HieuTkZ/Graduation-internship-LoRaWAN-Smoke-Monitor/csv_downloaded/smoke_log_1_2026-09-26_20-32-47/comparison_normalized.png

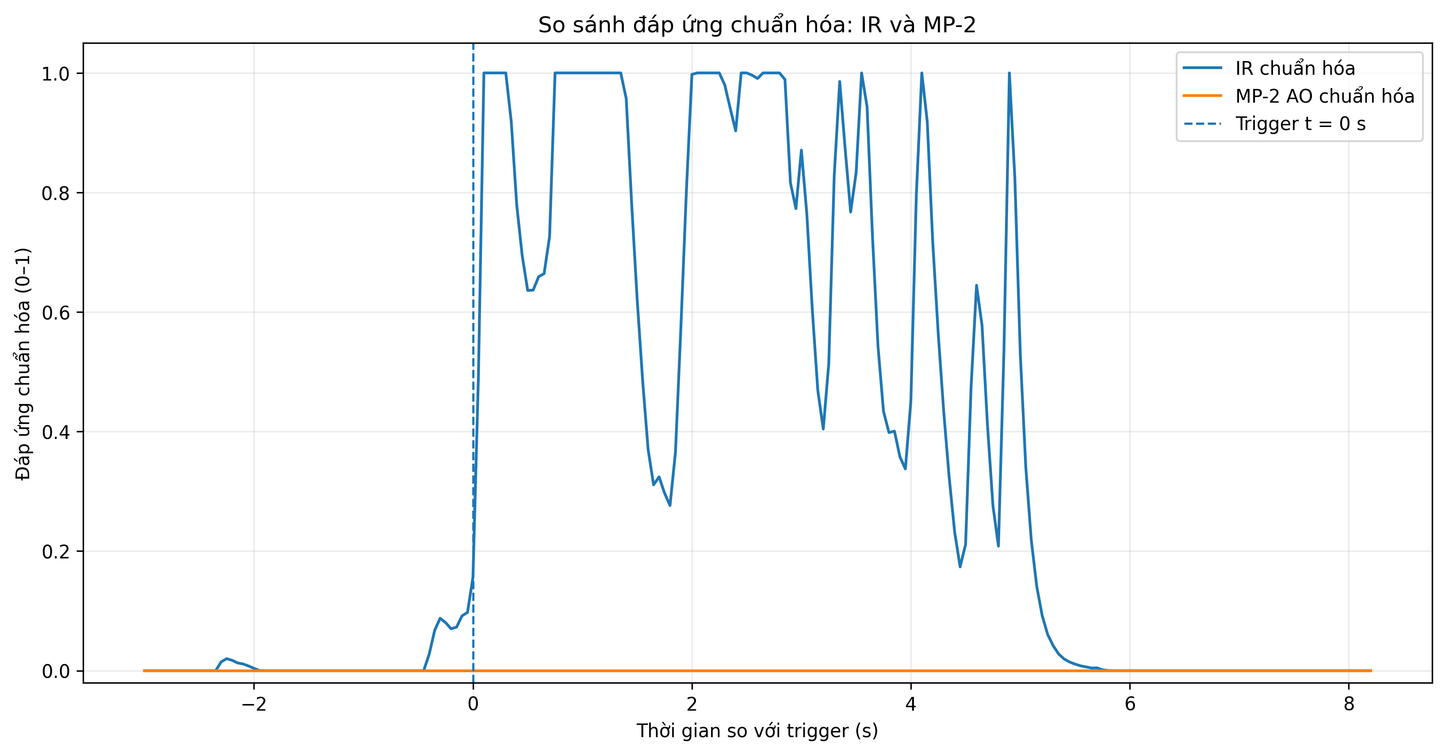
csv_downloaded/smoke_log_1_2026-09-26_20-32-47/comparison_normalized.png
