HieuTkZ/Graduation-internship-LoRaWAN-Smoke-Monitor/(list of files, drawings)

Other design files:
SmokeMonitor/Esp32_SmokeMonitor.pdsprj
